VictorChafu/HornSystem_PCB/CommunicationBoard/CommBoard/CommBoard.pdf

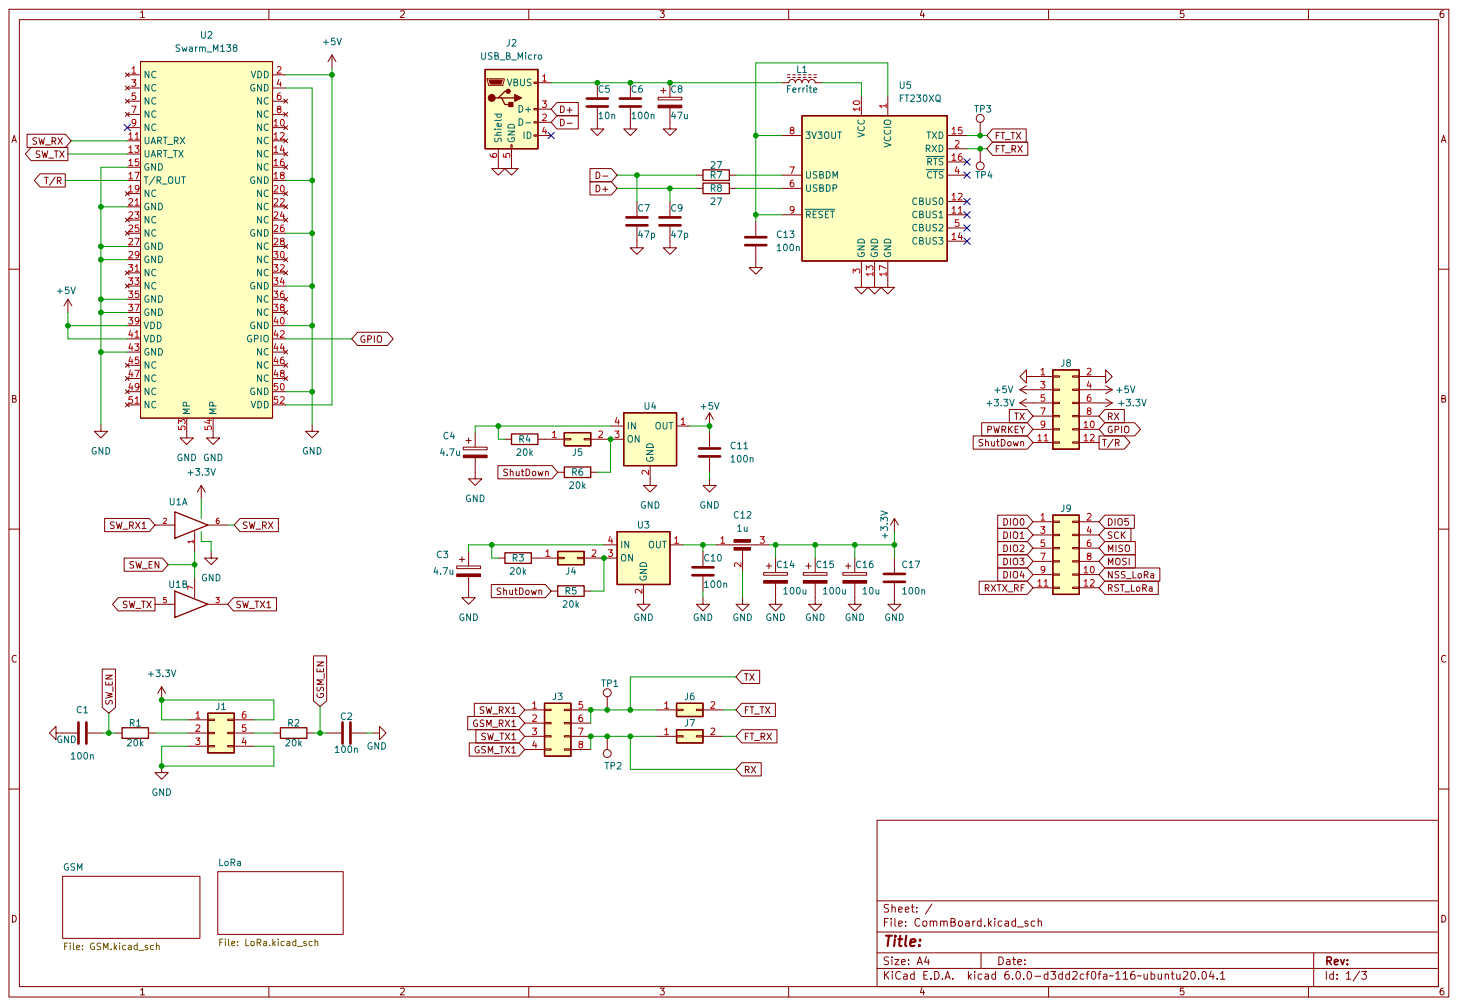
[picture p1: page 1]

1 VCC 10 CBUS1 11 CBUS0 12 GND 13 CBUS3 14 TXD 15 ~{RTS} 16 GND 17 RXD 2 GND

File: CommBoard.kicad_sch Sheet: / GSM

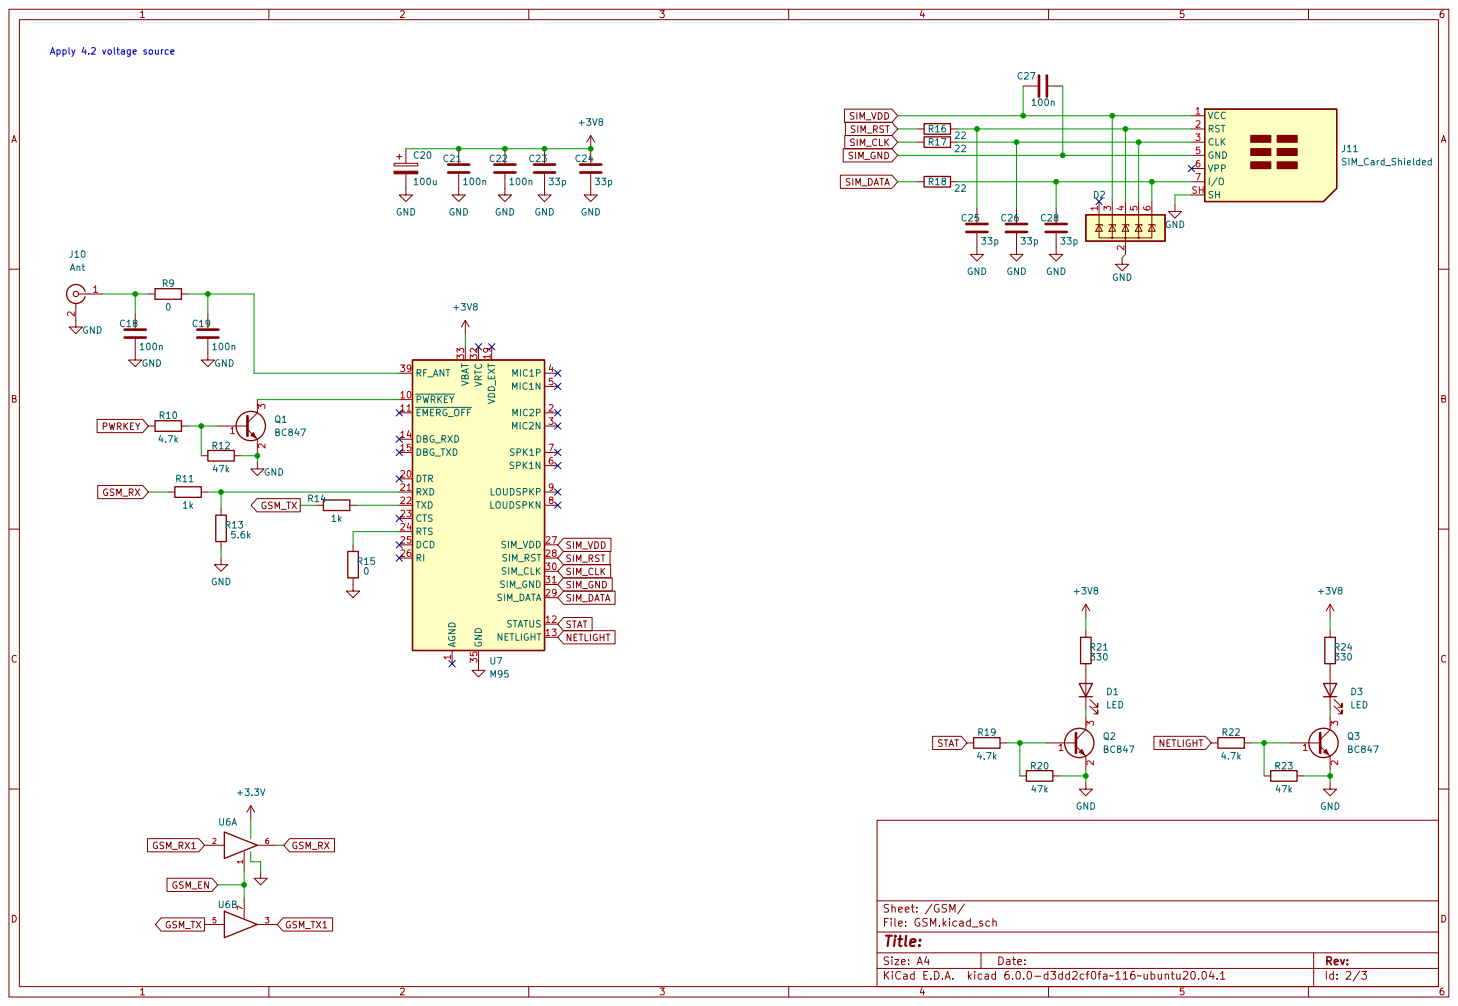
[picture p2: page 2]

VCC 1 RST 2 CLK 3 GND 5 VPP 6

1 ~{PWRKEY} 10 ~{EMERG_OFF} 11 STATUS 12 NETLIGHT 13 DBG_RXD 14 DBG_TXD 15 VDD_EXT 19 MIC2P 2 DTR 20 RXD 21 TXD 22 CTS 23 RTS 24 DCD 25 RI 26 SIM_VDD 27 SIM_RST 28 SIM_DATA 29 MIC2N 3 SIM_CLK 30 SIM_GND 31 VRTC 32 VBAT 33 GND 35 RF_ANT 39 MIC1P 4 MIC1N 5 SPK1N 6 SPK1P 7

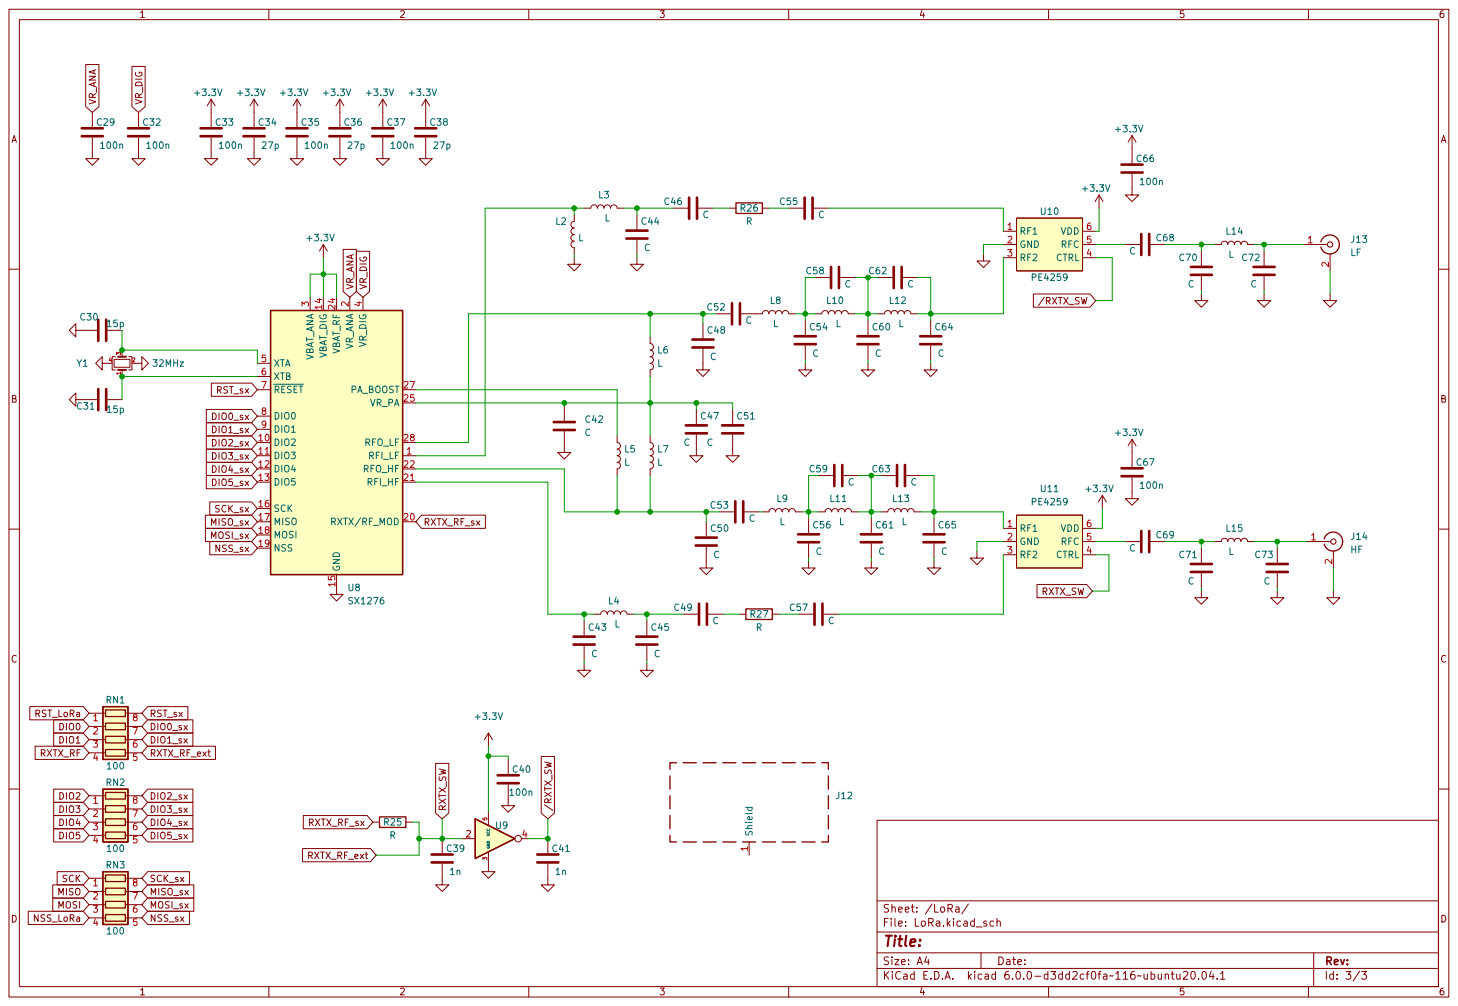
[picture p3: page 3]

File: LoRa.kicad_sch Sheet: /LoRa/
Id: 3/3 Title:
