VictorChafu/HornSystem_PCB/CommunicationBoard/CommBoard/CommBoard.kicad_pcb

## KiCad design CommunicationBoard/CommBoard/CommBoard.kicad_pcb (2022-12-02)

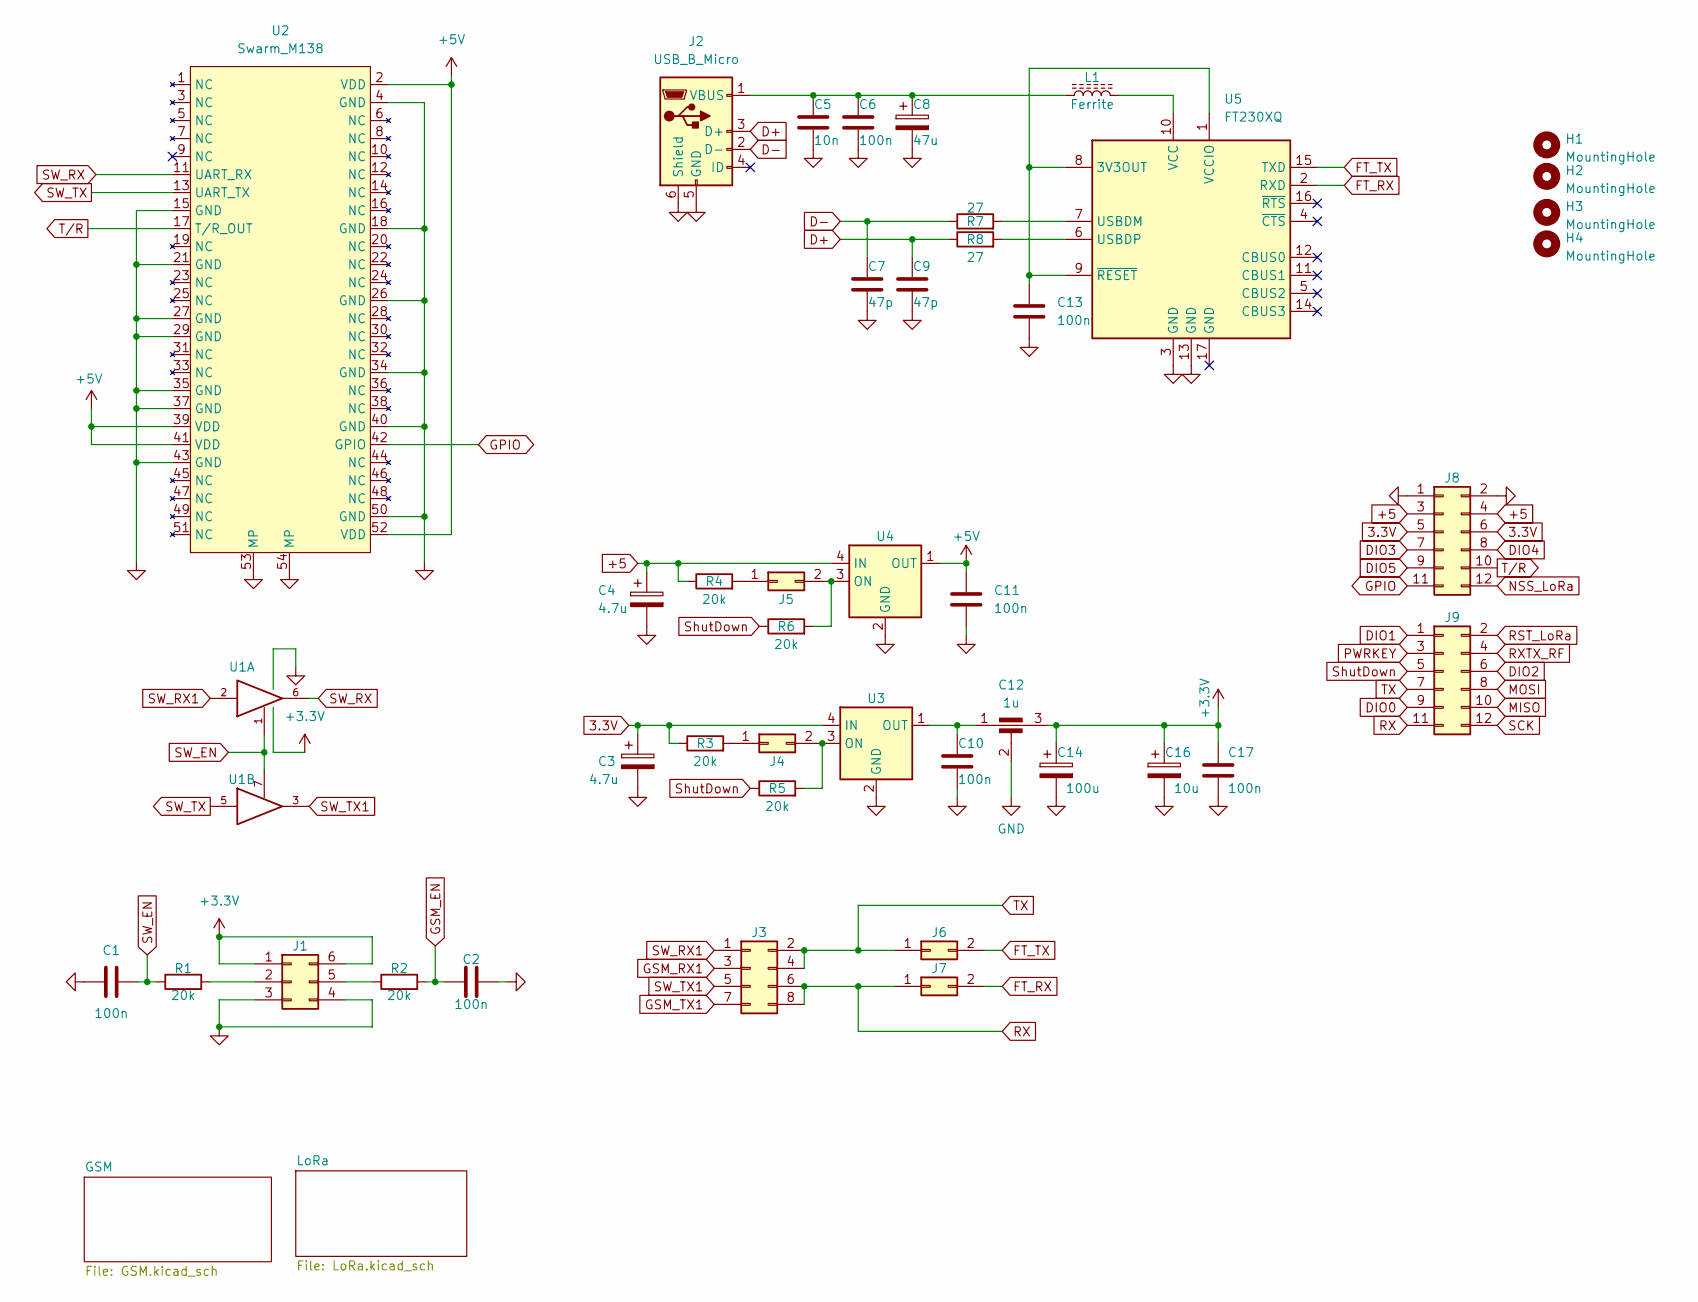
[picture p4: schematic CommBoard.kicad_sch]

Parts:
C1, C2, C6, C10, C11, C13, C17: 100n; C_0402_1005Metric
C3, C4: 4.7u; CP_Elec_6.3x5.2
C5: 10n; C_0402_1005Metric
C7, C9: 47p; C_0402_1005Metric
C8: 47u; CP_Elec_6.3x5.2
C12: 1u; YFF31HC
C14: 100u; CP_Elec_6.3x5.2
C16: 10u; CP_Elec_6.3x5.2
H1, H2, H3, H4: MountingHole; MountingHole_2.5mm
J1: Conn_02x03_Counter_Clockwise; PinHeader_2x03_P2.54mm_Vertical
J2: USB_B_Micro; USB_Micro-B_Molex_47346-0001
J3: Conn_02x04_Top_Bottom; PinHeader_2x04_P2.54mm_Vertical
J4, J5, J6, J7: Conn_02x01; PinHeader_2x01_P2.54mm_Vertical
J8, J9: Conn_02x06_Odd_Even; PinHeader_2x06_P2.54mm_Vertical
L1: Ferrite; L_0402_1005Metric
R1, R2, R3, R4, R5, R6: 20k; R_0402_1005Metric
R7, R8: 27; R_0402_1005Metric
U1: 74LVC2G126; VSSOP-8_2.4x2.1mm_P0.5mm
U2: Swarm_M138; BUS_PCI_Express_Mini_Dual
U3, U4: SiP35508; SOT-23-6
U5: FT230XQ; SSOP-16_3.9x4.9mm_P0.635mm

Connections:
3.3V: C3.1, J8.5, J8.6, R3.1, U3.4 (IN)
+3V3: C12.3, C14.1, C16.1, C17.1, J1.1, J1.6, U1.8 (VCC); also elsewhere on the board
+5: C4.1, J8.3, J8.4, R4.1, U4.4 (IN)
+5V: C11.1, U2.2 (VDD), U2.39 (VDD), U2.41 (VDD), U2.52 (VDD), U4.1 (OUT); also elsewhere on the board
D+: C9.1, J2.3 (D+), R8.1
D-: C7.1, J2.2 (D-), R7.1
DIO0: J9.9; also elsewhere on the board
DIO1: J9.1; also elsewhere on the board
DIO2: J9.6; also elsewhere on the board
DIO3: J8.7; also elsewhere on the board
DIO4: J8.8; also elsewhere on the board
DIO5: J8.9; also elsewhere on the board
FT_RX: J7.2, U5.2 (RXD)
FT_TX: J6.2, U5.15 (TXD)
GND: C1.1, C2.2, C3.2, C4.2, C5.2, C6.2, C7.2, C8.2, C9.2, C10.2, C11.2, C12.2, C13.2, C14.2, C16.2, C17.2, J1.3, J1.4, J2.5 (GND), J2.6 (Shield), J8.1, J8.2, U1.4 (GND), U2.4 (GND), U2.15 (GND), U2.18 (GND), U2.21 (GND), U2.26 (GND), U2.27 (GND), U2.29 (GND), U2.34 (GND), U2.35 (GND), U2.37 (GND), U2.40 (GND), U2.43 (GND), U2.50 (GND), U2.53 (MP), U2.54 (MP), U3.2 (GND), U3.5 (GND), U4.2 (GND), U4.5 (GND), U5.3 (GND), U5.13 (GND); also elsewhere on the board
GPIO: J8.11, U2.42 (GPIO)
GSM_EN: C2.1, R2.2; also elsewhere on the board
GSM_RX1: J3.3; also elsewhere on the board
GSM_TX1: J3.7; also elsewhere on the board
MISO: J9.10; also elsewhere on the board
MOSI: J9.8; also elsewhere on the board
NSS_LoRa: J8.12; also elsewhere on the board
unnamed: C5.1, C6.1, C8.1, J2.1 (VBUS), L1.1
unnamed: C10.1, C12.1, U3.1 (OUT)
unnamed: C13.1, U5.1 (VCCIO), U5.8 (3V3OUT), U5.9 (~RESET)
unnamed: J1.2, R1.2
unnamed: J1.5, R2.1
unnamed: J4.1, R3.2
unnamed: J4.2, R5.2, U3.3 (ON)
unnamed: J5.1, R4.2
unnamed: J5.2, R6.2, U4.3 (ON)
unnamed: L1.2, U5.10 (VCC)
unnamed: R7.2, U5.7 (USBDM)
unnamed: R8.2, U5.6 (USBDP)
PWRKEY: J9.3; also elsewhere on the board
RST_LoRa: J9.2; also elsewhere on the board
RX: J3.6, J3.8, J7.1, J9.11
RXTX_RF: J9.4; also elsewhere on the board
SCK: J9.12; also elsewhere on the board
SW_EN: C1.2, R1.1, U1.1, U1.7
SW_RX: U1.6, U2.11 (UART_RX)
SW_RX1: J3.1, U1.2
SW_TX: U1.5, U2.13 (UART_TX)
SW_TX1: J3.5, U1.3
ShutDown: J9.5, R5.1, R6.1
TX: J3.2, J3.4, J6.1, J9.7
T/R: J8.10, U2.17 (T/R_OUT)

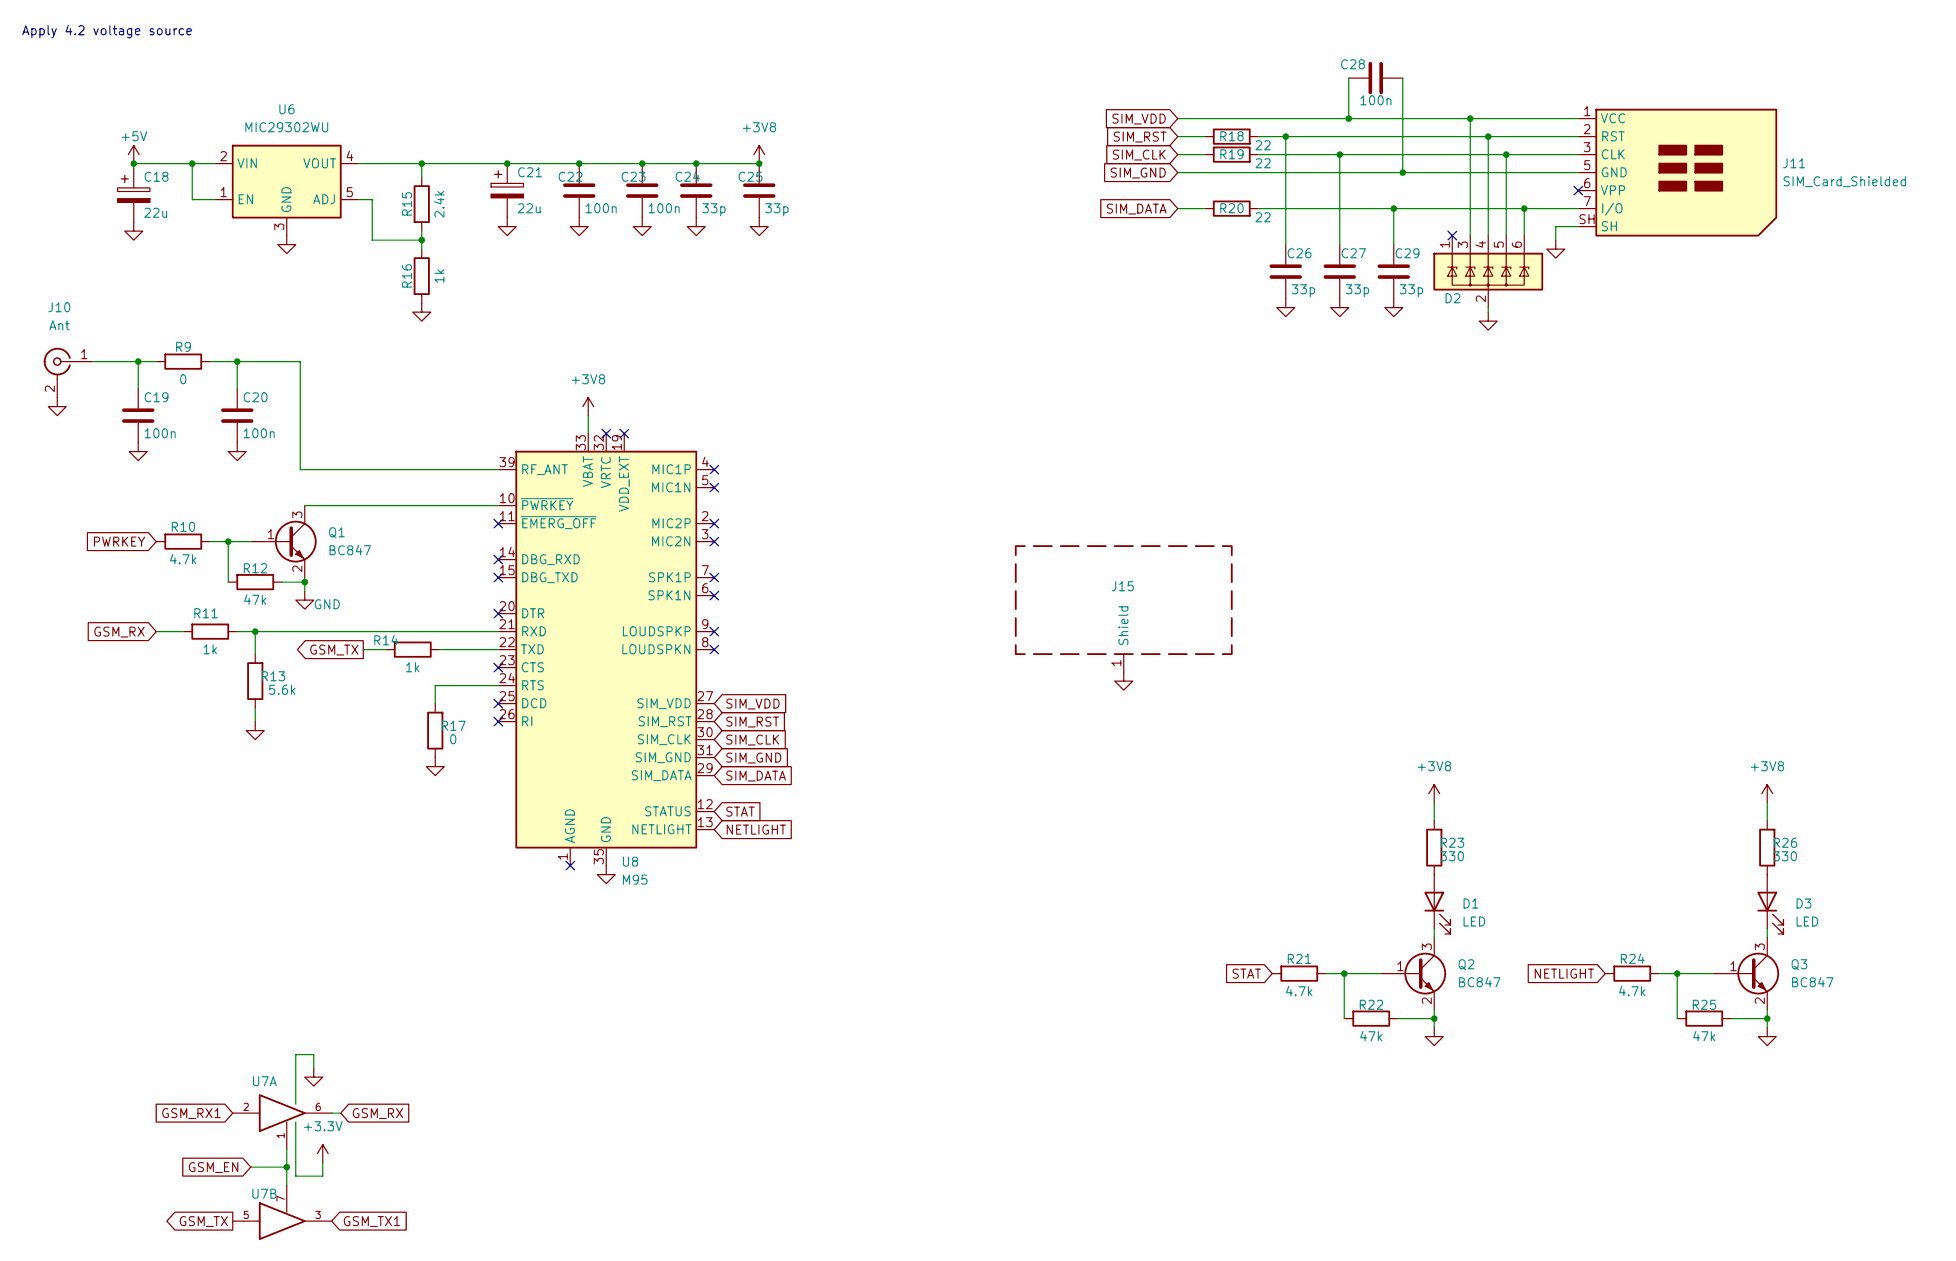
[picture p5: schematic GSM.kicad_sch]

Parts:
C18, C21: 22u; CP_Elec_6.3x5.2
C19, C20, C22, C23, C28: 100n; C_0402_1005Metric
C24, C25, C26, C27, C29: 33p; C_0402_1005Metric
D1, D3: LED; LED_0805_2012Metric
D2: ESDA6V1-5SC6; SOT-23-6
J10: Ant; U.FL_Hirose_U.FL-R-SMT-1_Vertical
J11: SIM_Card_Shielded; microSIM_JAE_SF53S006VCBR2000
J15: RFShield_OnePiece; Laird_Technologies_BMI-S-205-F_38.10x25.40mm
Q1, Q2, Q3: BC847; SOT-23
R9: 0; R_0402_1005Metric
R10, R21, R24: 4.7k; R_0402_1005Metric
R11, R14: 1k; R_0402_1005Metric
R12, R22, R25: 47k; R_0402_1005Metric
R13: 5.6k; R_0402_1005Metric
R15: 2.4k; R_0805_2012Metric
R16: 1k; R_0805_2012Metric
R17: 0; R_0805_2012Metric
R18, R19, R20: 22; R_0402_1005Metric
R23, R26: 330; R_0402_1005Metric
U6: MIC29302WU; TO-263-5_TabPin3
U7: 74LVC2G126; VSSOP-8_2.4x2.1mm_P0.5mm
U8: M95; Quectel_M95

Connections:
+3V3: U7.8 (VCC); also elsewhere on the board
+3V8: C21.1, C22.1, C23.1, C24.1, C25.1, R15.1, R23.2, R26.2, U6.4 (VOUT), U8.33 (VBAT), U8.34 (VBAT)
+5V: C18.1, U6.1 (EN), U6.2 (VIN); also elsewhere on the board
GND: C18.2, C19.2, C20.2, C21.2, C22.2, C23.2, C24.2, C25.2, C26.2, C27.2, C29.2, D2.2 (GND), J10.2 (Ext), J11.SH, J15.1 (Shield), Q1.2 (E), Q2.2 (E), Q3.2 (E), R12.1, R13.1, R16.2, R17.1, R22.1, R25.1, U6.3 (GND), U7.4 (GND), U8.35 (GND), U8.36 (GND), U8.37 (GND), U8.38 (GND), U8.40 (GND); also elsewhere on the board
GSM_EN: U7.1, U7.7; also elsewhere on the board
GSM_RX: R11.2, U7.6
GSM_RX1: U7.2; also elsewhere on the board
GSM_TX: R14.2, U7.5
GSM_TX1: U7.3; also elsewhere on the board
NETLIGHT: R24.2, U8.13 (NETLIGHT)
unnamed: C19.1, J10.1 (In), R9.2
unnamed: C20.1, R9.1, U8.39 (RF_ANT)
unnamed: C26.1, D2.4 (IO3), J11.2 (RST), R18.2
unnamed: C27.1, D2.5 (IO4), J11.3 (CLK), R19.2
unnamed: C29.1, D2.6 (IO5), J11.7 (I/O), R20.2
unnamed: D1.1 (K), Q2.3 (C)
unnamed: D1.2 (A), R23.1
unnamed: D3.1 (K), Q3.3 (C)
unnamed: D3.2 (A), R26.1
unnamed: Q1.1 (B), R10.1, R12.2
unnamed: Q1.3 (C), U8.10 (~PWRKEY)
unnamed: Q2.1 (B), R21.1, R22.2
unnamed: Q3.1 (B), R24.1, R25.2
unnamed: R11.1, R13.2, U8.21 (RXD)
unnamed: R14.1, U8.22 (TXD)
unnamed: R15.2, R16.1, U6.5 (ADJ)
unnamed: R17.2, U8.24 (RTS)
PWRKEY: R10.2; also elsewhere on the board
SIM_CLK: R19.1, U8.30 (SIM_CLK)
SIM_DATA: R20.1, U8.29 (SIM_DATA)
SIM_GND: C28.2, J11.5 (GND), U8.31 (SIM_GND)
SIM_RST: R18.1, U8.28 (SIM_RST)
SIM_VDD: C28.1, D2.3 (IO2), J11.1 (VCC), U8.27 (SIM_VDD)
STAT: R21.2, U8.12 (STATUS)

Notes on the sheet:
Apply 4.2 voltage source

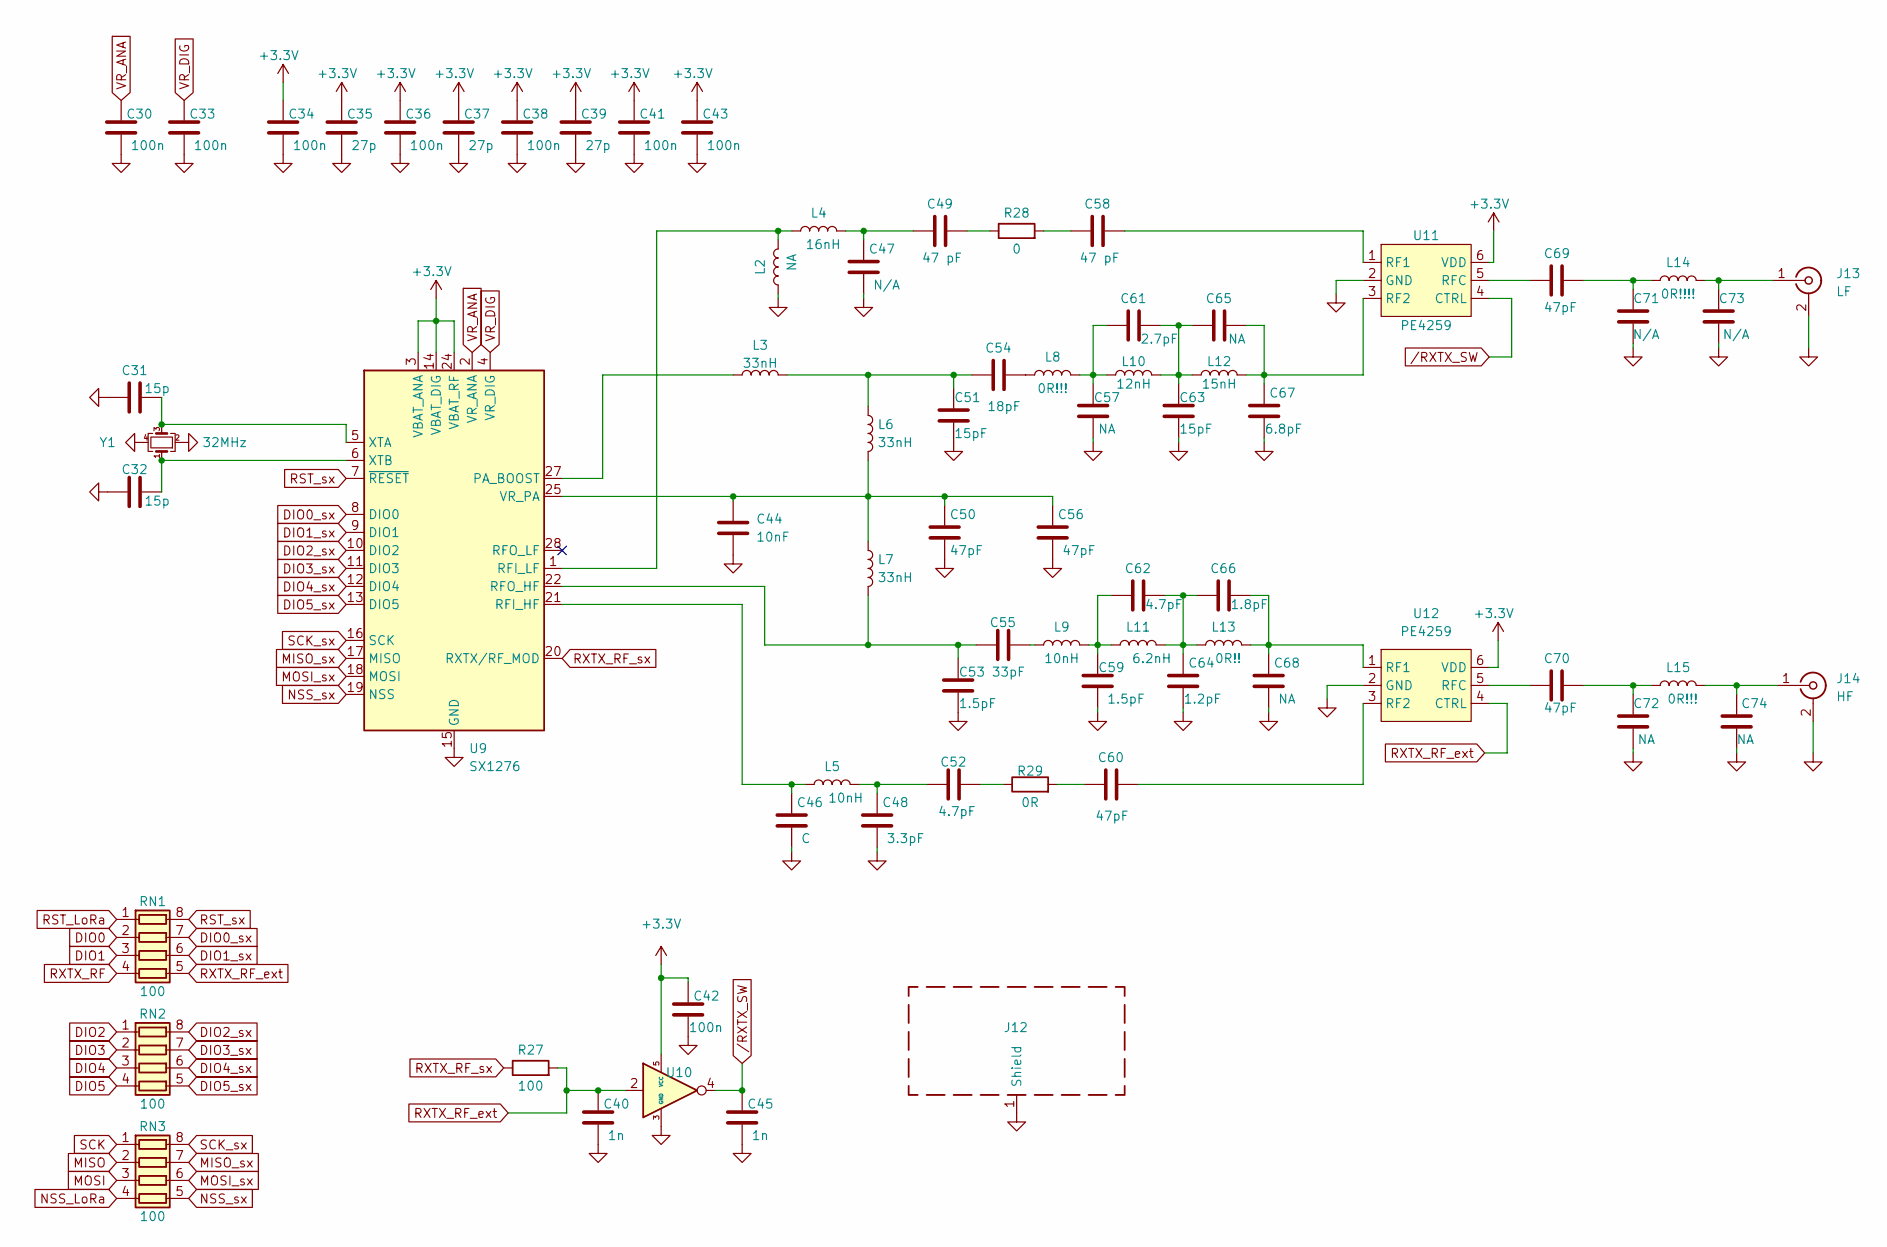
[picture p6: schematic LoRa.kicad_sch]

Parts:
C30, C33, C34, C36, C38, C41, C42, C43: 100n; C_0402_1005Metric
C31, C32: 15p; C_0402_1005Metric
C35, C37, C39: 27p; C_0402_1005Metric
C40, C45: 1n; C_0402_1005Metric
C44: 10nF; C_0402_1005Metric
C46: C; C_0402_1005Metric
C47, C71, C73: N/A; C_0402_1005Metric
C48: 3.3pF; C_0402_1005Metric
C49, C58: 47 pF; C_0402_1005Metric
C50, C56, C60, C69, C70: 47pF; C_0402_1005Metric
C51, C63: 15pF; C_0402_1005Metric
C52, C62: 4.7pF; C_0402_1005Metric
C53, C59: 1.5pF; C_0402_1005Metric
C54: 18pF; C_0402_1005Metric
C55: 33pF; C_0402_1005Metric
C57, C65, C68, C72, C74: NA; C_0402_1005Metric
C61: 2.7pF; C_0402_1005Metric
C64: 1.2pF; C_0402_1005Metric
C66: 1.8pF; C_0402_1005Metric
C67: 6.8pF; C_0402_1005Metric
J12: RFShield_OnePiece; Laird_Technologies_BMI-S-205-F_38.10x25.40mm
J13: LF; U.FL_Hirose_U.FL-R-SMT-1_Vertical
J14: HF; U.FL_Hirose_U.FL-R-SMT-1_Vertical
L2: NA; L_0402_1005Metric
L3, L6, L7: 33nH; L_0402_1005Metric
L4: 16nH; L_0402_1005Metric
L5, L9: 10nH; L_0402_1005Metric
L8, L15: 0R!!!; L_0402_1005Metric
L10: 12nH; L_0402_1005Metric
L11: 6.2nH; L_0402_1005Metric
L12: 15nH; L_0402_1005Metric
L13: 0R!!; L_0402_1005Metric
L14: 0R!!!!; L_0402_1005Metric
R27: 100; R_0402_1005Metric
R28: 0; R_0201_0603Metric
R29: 0R; R_0201_0603Metric_Pad0.64x0.40mm_HandSolder
RN1, RN2, RN3: 100; R_Array_Convex_4x1206
U9: SX1276; QFN-28-1EP_6x6mm_P0.65mm_EP4.8x4.8mm
U10: NC7SVU04P5X; SOT-353_SC-70-5
U11, U12: PE4259; SC70-6
Y1: 32MHz; Crystal_SMD_Abracon_ABM8G-4Pin_3.2x2.5mm

Connections:
+3V3: C34.1, C35.1, C36.1, C37.1, C38.1, C39.1, C41.1, C42.1, C43.1, U9.3 (VBAT_ANA), U9.14 (VBAT_DIG), U9.24 (VBAT_RF), U10.5 (VCC), U11.6 (VDD), U12.6 (VDD); also elsewhere on the board
DIO0: RN1.2 (R2.1); also elsewhere on the board
DIO0_sx: RN1.7 (R2.2), U9.8 (DIO0)
DIO1: RN1.3 (R3.1); also elsewhere on the board
DIO1_sx: RN1.6 (R3.2), U9.9 (DIO1)
DIO2: RN2.1 (R1.1); also elsewhere on the board
DIO2_sx: RN2.8 (R1.2), U9.10 (DIO2)
DIO3: RN2.2 (R2.1); also elsewhere on the board
DIO3_sx: RN2.7 (R2.2), U9.11 (DIO3)
DIO4: RN2.3 (R3.1); also elsewhere on the board
DIO4_sx: RN2.6 (R3.2), U9.12 (DIO4)
DIO5: RN2.4 (R4.1); also elsewhere on the board
DIO5_sx: RN2.5 (R4.2), U9.13 (DIO5)
GND: C30.2, C31.1, C32.1, C33.2, C34.2, C35.2, C36.2, C37.2, C38.2, C39.2, C40.2, C41.2, C42.2, C43.2, C44.2, C45.2, C46.2, C47.2, C48.2, C50.2, C51.2, C53.2, C56.2, C57.2, C59.2, C63.2, C64.2, C67.2, C68.2, C71.2, C72.2, C73.2, C74.2, J12.1, J13.2 (Ext), J14.2 (Ext), L2.1, U9.15 (GND), U9.23 (GND), U9.26 (GND), U9.29 (GND), U10.3 (GND), U11.2 (GND), U12.2 (GND), Y1.2, Y1.4; also elsewhere on the board
MISO: RN3.2 (R2.1); also elsewhere on the board
MISO_sx: RN3.7 (R2.2), U9.17 (MISO)
MOSI: RN3.3 (R3.1); also elsewhere on the board
MOSI_sx: RN3.6 (R3.2), U9.18 (MOSI)
NSS_LoRa: RN3.4 (R4.1); also elsewhere on the board
NSS_sx: RN3.5 (R4.2), U9.19 (NSS)
unnamed: C31.2, U9.5 (XTA), Y1.3
unnamed: C32.2, U9.6 (XTB), Y1.1
unnamed: C44.1, C50.1, C56.1, L6.2, L7.1, U9.25 (VR_PA)
unnamed: C46.1, L5.1, U9.21 (RFI_HF)
unnamed: C47.1, C49.1, L4.2
unnamed: C48.1, C52.1, L5.2
unnamed: C49.2, R28.1
unnamed: C51.1, C54.1, L3.2, L6.1
unnamed: C52.2, R29.1
unnamed: C53.1, C55.1, L7.2, U9.22 (RFO_HF)
unnamed: C54.2, L8.1
unnamed: C55.2, L9.1
unnamed: C57.1, C61.1, L8.2, L10.1
unnamed: C58.1, R28.2
unnamed: C58.2, U11.1 (RF1)
unnamed: C59.1, C62.1, L9.2, L11.1
unnamed: C60.1, R29.2
unnamed: C60.2, U12.3 (RF2)
unnamed: C61.2, C63.1, C65.1, L10.2, L12.1
unnamed: C62.2, C64.1, C66.1, L11.2, L13.1
unnamed: C65.2, C67.1, L12.2, U11.3 (RF2)
unnamed: C66.2, C68.1, L13.2, U12.1 (RF1)
unnamed: C69.1, C71.1, L14.2
unnamed: C69.2, U11.5 (RFC)
unnamed: C70.1, C72.1, L15.2
unnamed: C70.2, U12.5 (RFC)
unnamed: C73.1, J13.1 (In), L14.1
unnamed: C74.1, J14.1 (In), L15.1
unnamed: L2.2, L4.1, U9.1 (RFI_LF)
unnamed: L3.1, U9.27 (PA_BOOST)
RST_LoRa: RN1.1 (R1.1); also elsewhere on the board
RST_sx: RN1.8 (R1.2), U9.7 (~RESET)
RXTX_RF: RN1.4 (R4.1); also elsewhere on the board
RXTX_RF_ext: C40.1, R27.2, RN1.5 (R4.2), U10.2, U12.4 (CTRL)
RXTX_RF_sx: R27.1, U9.20 (RXTX/RF_MOD)
SCK: RN3.1 (R1.1); also elsewhere on the board
SCK_sx: RN3.8 (R1.2), U9.16 (SCK)
VR_ANA: C30.1, U9.2 (VR_ANA)
VR_DIG: C33.1, U9.4 (VR_DIG)
/RXTX_SW: C45.1, U10.4, U11.4 (CTRL)

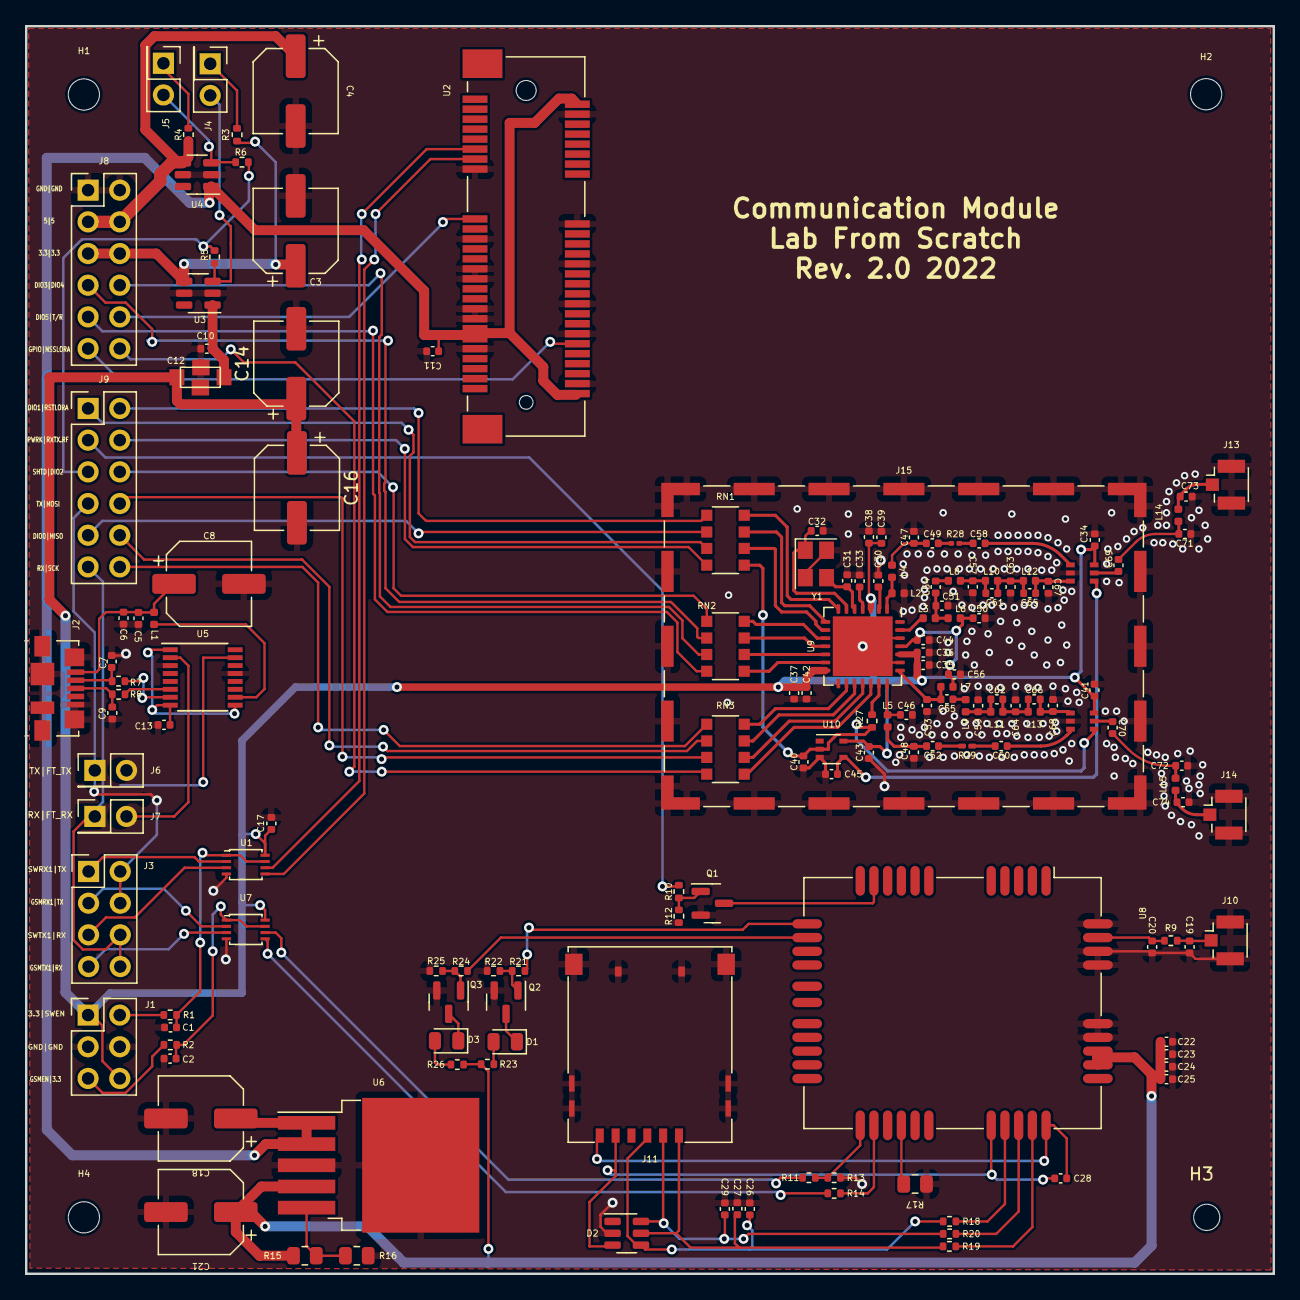
[picture p7: board CommBoard.kicad_pcb from above]

Board: 2 copper layers, 100.0 x 100.0 mm, 157 parts (0 on the bottom side), 120 nets.
