VictorChafu/HornSystem_PCB/power_board/PCB-DESIGN/power_board.kicad_pcb

## KiCad design power_board/PCB-DESIGN/power_board.kicad_pcb (2022-12-02)

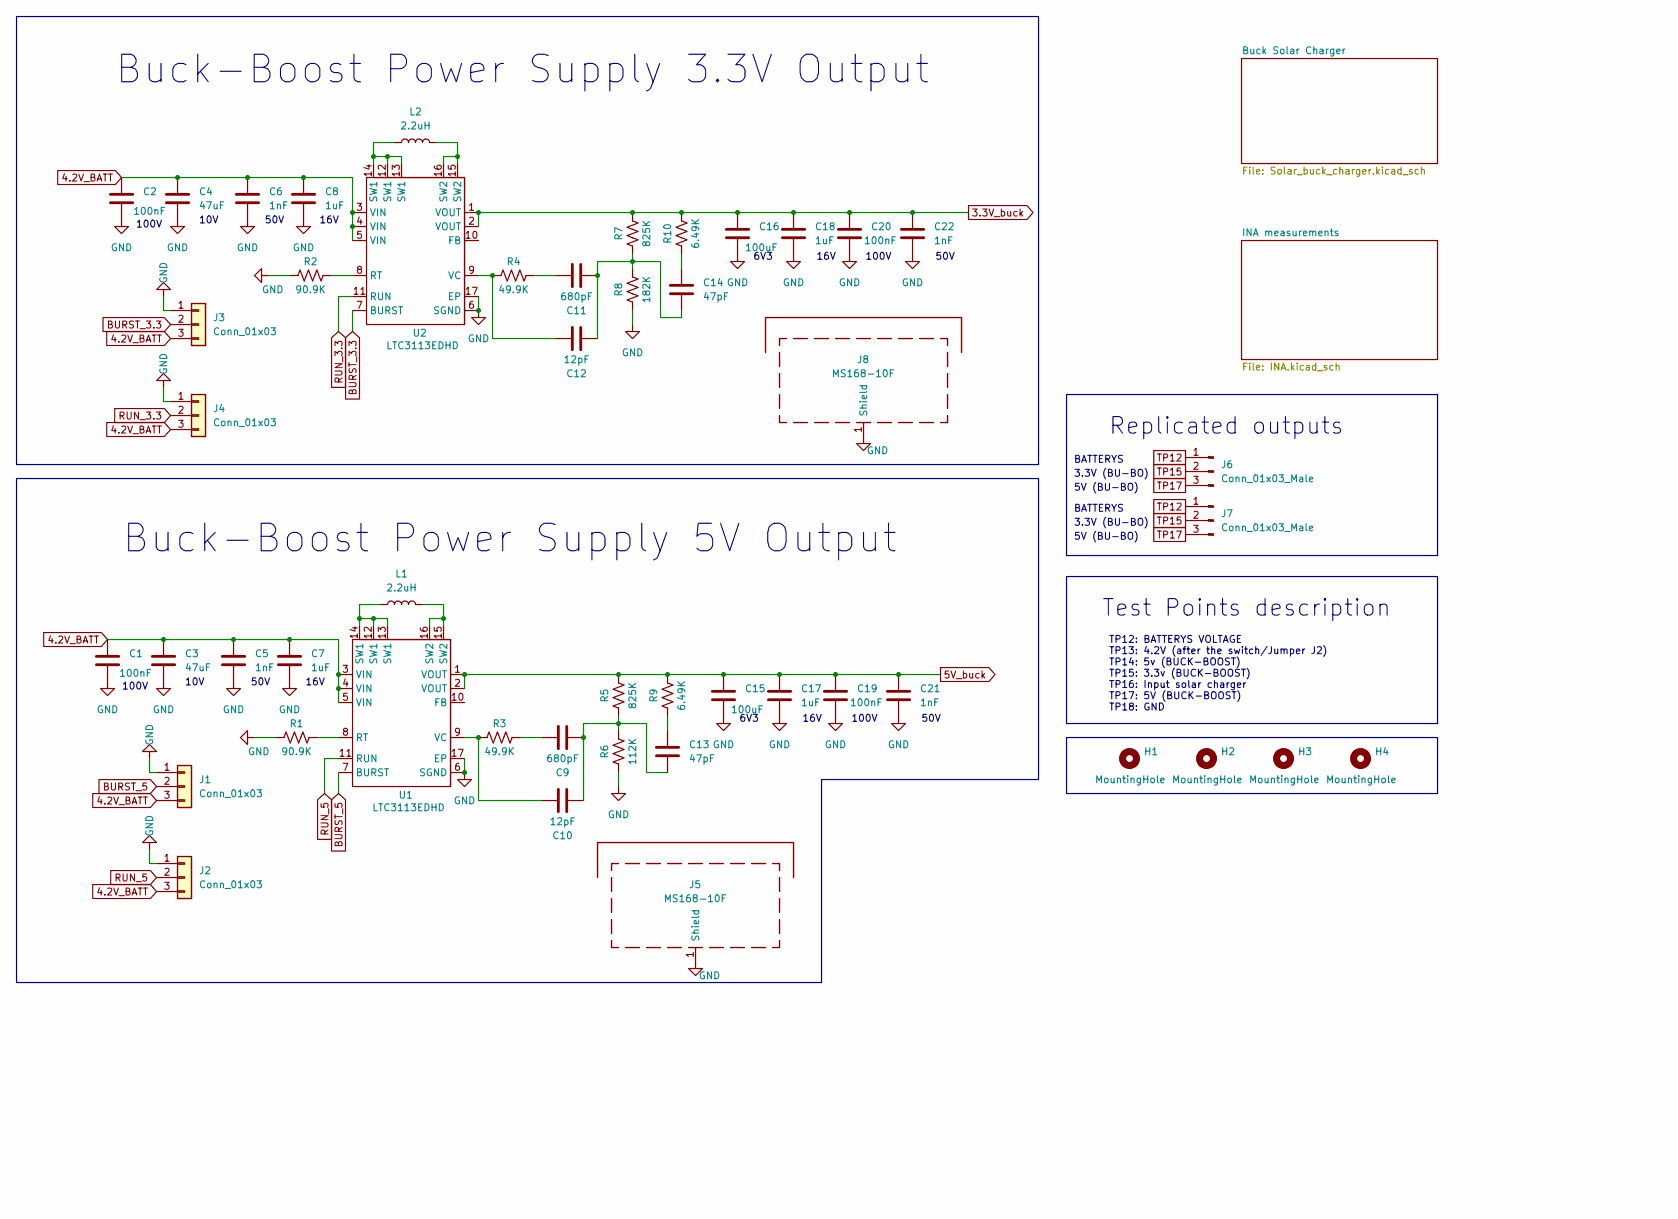
[picture p8: schematic power_board.kicad_sch, Navy System. Power Board, part in row 1, column 1]

Parts:
C1, C2, C19, C20: 100nF; C_0805_2012Metric
C3, C4: 47uF; C_0805_2012Metric
C5, C6, C21, C22: 1nF; C_0805_2012Metric
C7, C8, C17, C18: 1uF; C_0805_2012Metric
C9, C11: 680pF; C_0805_2012Metric
C10, C12: 12pF; C_0805_2012Metric
C13, C14: 47pF; C_0805_2012Metric
C15, C16: 100uF; C_0805_2012Metric
H1, H2, H3, H4: MountingHole; MountingHole_2.5mm
J1, J2, J3, J4: Conn_01x03; PinHeader_1x03_P2.54mm_Vertical
J5, J8: MS168-10F; Wuerth_36103205_20x20mm
J6, J7: Conn_01x03_Male; PinHeader_1x03_P2.54mm_Vertical
L1, L2: 2.2uH; L_Vishay_IHLP-2525
R1, R2: 90.9K; R_0805_2012Metric
R3, R4: 49.9K; R_0805_2012Metric
R5, R7: 825K; R_0805_2012Metric
R6: 112K; R_0805_2012Metric
R8: 182K; R_0805_2012Metric
R9, R10: 6.49K; R_0805_2012Metric
U1, U2: LTC3113EDHD; SSOP-20_4.4x6.5mm_P0.65mm

Connections:
3.3V_buck: C16.1, C18.1, C20.1, C22.1, R7.1, R10.1, U2.1 (VOUT), U2.2 (VOUT); also elsewhere on the board
4.2V_BATT: C1.1, C2.1, C3.1, C4.1, C5.1, C6.1, C7.1, C8.1, J1.3, J2.3, J3.3, J4.3, J6.1, J7.1, U1.3 (VIN), U1.4 (VIN), U1.5 (VIN), U2.3 (VIN), U2.4 (VIN), U2.5 (VIN); also elsewhere on the board
5V_buck: C15.1, C17.1, C19.1, C21.1, R5.1, R9.1, U1.1 (VOUT), U1.2 (VOUT); also elsewhere on the board
BURST_3.3: J3.2, U2.7 (BURST)
BURST_5: J1.2, U1.7 (BURST)
GND: C1.2, C2.2, C3.2, C4.2, C5.2, C6.2, C7.2, C8.2, C15.2, C16.2, C17.2, C18.2, C19.2, C20.2, C21.2, C22.2, J1.1, J2.1, J3.1, J4.1, J5.1 (Shield), J8.1 (Shield), R1.2, R2.2, R6.2, R8.2, U1.6 (SGND), U1.17 (EP), U2.6 (SGND), U2.17 (EP); also elsewhere on the board
unnamed: C9.2, R3.1
unnamed: C9.1, C10.1, C13.2, R5.2, R6.1
unnamed: C10.2, R3.2, U1.9 (VC)
unnamed: C11.1, C12.1, C14.2, R7.2, R8.1
unnamed: C11.2, R4.1
unnamed: C12.2, R4.2, U2.9 (VC)
unnamed: C13.1, R9.2
unnamed: C14.1, R10.2
unnamed: L1.1, U1.12 (SW1), U1.13 (SW1), U1.14 (SW1)
unnamed: L1.2, U1.15 (SW2), U1.16 (SW2)
unnamed: L2.1, U2.12 (SW1), U2.13 (SW1), U2.14 (SW1)
unnamed: L2.2, U2.15 (SW2), U2.16 (SW2)
unnamed: R1.1, U1.8 (RT)
unnamed: R2.1, U2.8 (RT)
RUN_3.3: J4.2, U2.11 (RUN)
RUN_5: J2.2, U1.11 (RUN)
TP15: J6.2, J7.2
TP17: J6.3, J7.3

Notes on the sheet:
16V
100V
TP12: BATTERYS VOLTAGE TP13: 4.2V (after the switch/Jumper J2) TP14: 5v (BUCK-BOOST) TP15: 3.3v (BUCK-BOOST) TP16: Input solar charger TP17: 5V (BUCK-BOOST) TP18: GND
3.3V (BU-BO)
50V
Buck-Boost Power Supply 3.3V Output
5V (BU-BO)
6V3
Buck-Boost Power Supply 5V Output
BATTERYS
10V
Replicated outputs
Test Points description

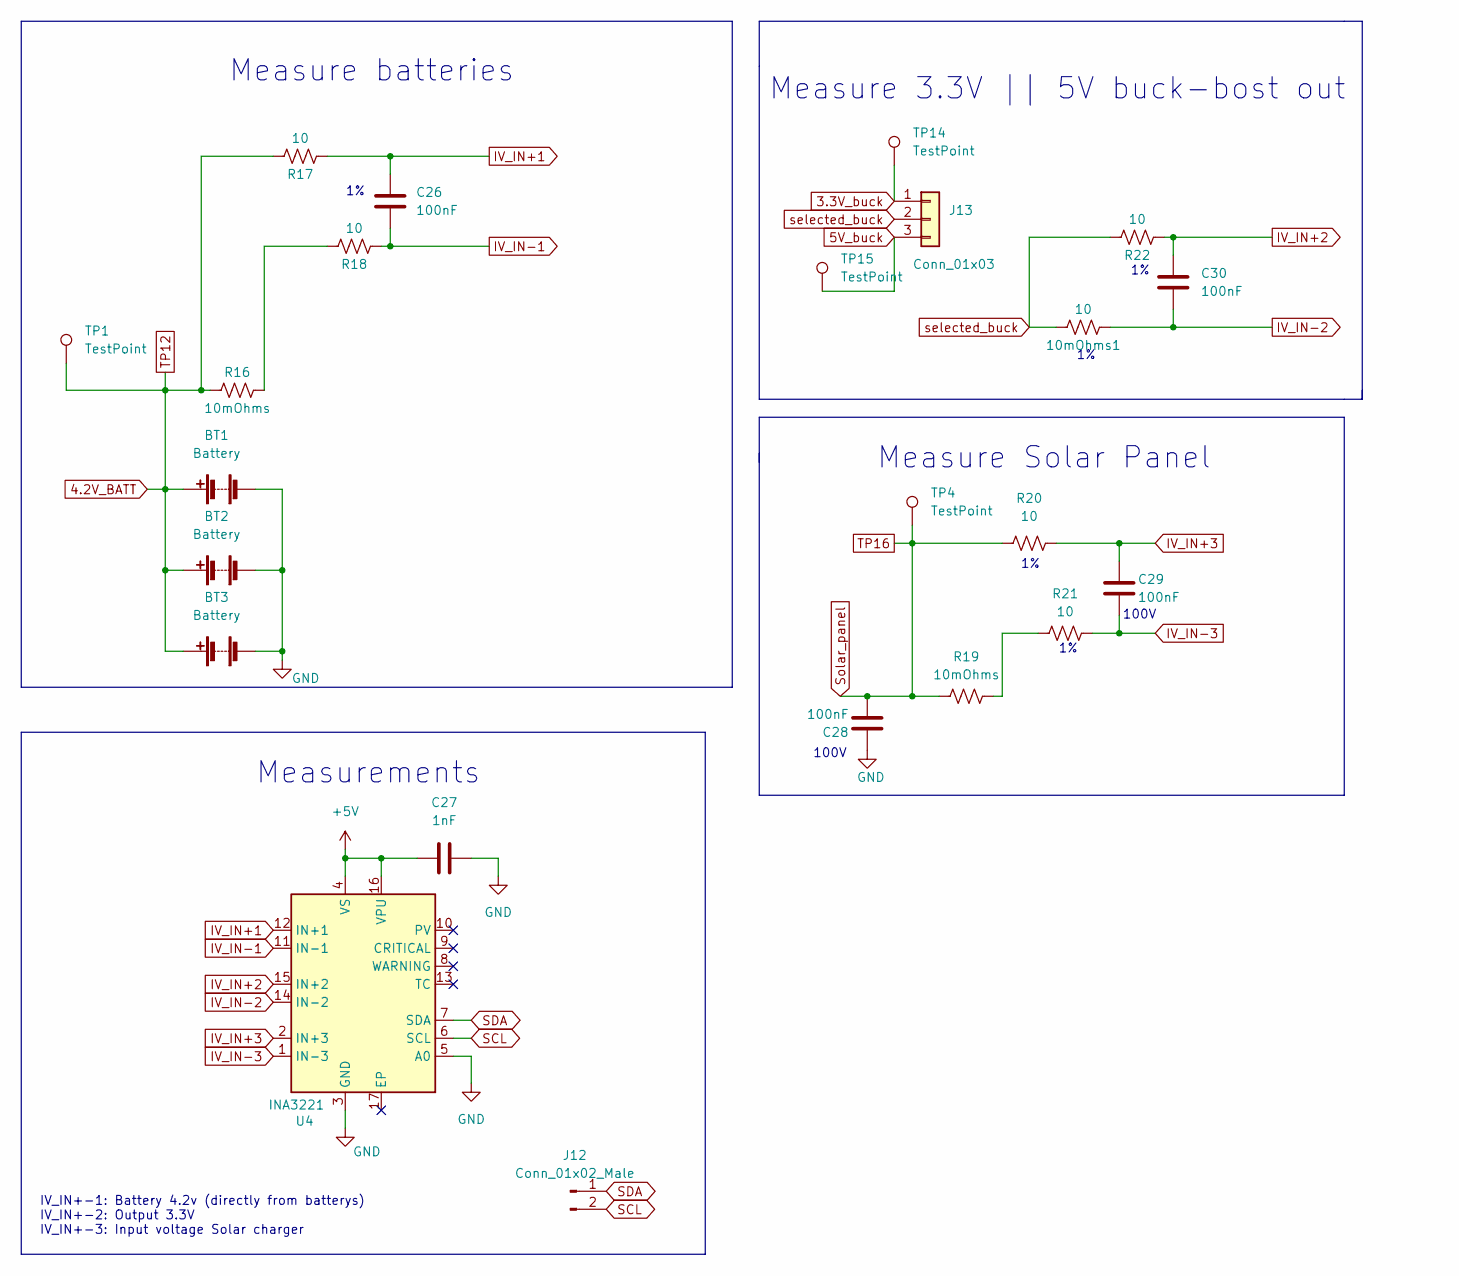
[picture p9: schematic INA.kicad_sch]

Parts:
10mOhms1: 10; R_0805_2012Metric
BT1, BT2, BT3: Battery; BatteryHolder_MPD_BH-18650-PC2
C26, C28, C29, C30: 100nF; C_0805_2012Metric
C27: 1nF; C_0805_2012Metric
J12: Conn_01x02_Male; PinHeader_1x02_P2.54mm_Vertical
J13: Conn_01x03; PinHeader_1x03_P2.54mm_Vertical
R16, R19: 10mOhms; R_0805_2012Metric
R17, R18, R20, R21, R22: 10; R_0805_2012Metric
TP1, TP4, TP14, TP15: TestPoint; TestPoint_Loop_D2.54mm_Drill1.5mm_Beaded
U4: INA3221; Texas_RGV_S-PVQFN-N16_EP2.1x2.1mm

Connections:
3.3V_buck: J13.1, TP14.1; also elsewhere on the board
4.2V_BATT: BT1.1 (+), BT2.1 (+), BT3.1 (+), R16.1, R17.1, TP1.1; also elsewhere on the board
5V_buck: J13.3, TP15.1; also elsewhere on the board
+5V: C27.1, U4.4 (VS), U4.16 (VPU)
GND: BT1.2 (-), BT2.2 (-), BT3.2 (-), C27.2, C28.1, U4.3 (GND), U4.5 (A0); also elsewhere on the board
IV_IN+1: C26.1, R17.2, U4.12 (IN+1)
IV_IN+2: C30.1, R22.2, U4.15 (IN+2)
IV_IN+3: C29.1, R20.1, U4.2 (IN+3)
IV_IN-1: C26.2, R18.2, U4.11 (IN-1)
IV_IN-2: 10mOhms1.2, C30.2, U4.14 (IN-2)
IV_IN-3: C29.2, R21.1, U4.1 (IN-3)
unnamed: R16.2, R18.1
unnamed: R19.1, R21.2
SCL: J12.2, U4.6 (SCL)
SDA: J12.1, U4.7 (SDA)
Solar_panel: C28.2, R19.2, R20.2, TP4.1; also elsewhere on the board
selected_buck: 10mOhms1.1, J13.2, R22.1

Notes on the sheet:
100V
Measure Solar Panel
Measurements
IV_IN+-1: Battery 4.2v (directly from batterys) IV_IN+-2: Output 3.3V IV_IN+-3: Input voltage Solar charger
Measure batteries
Measure 3.3V || 5V buck-bost out

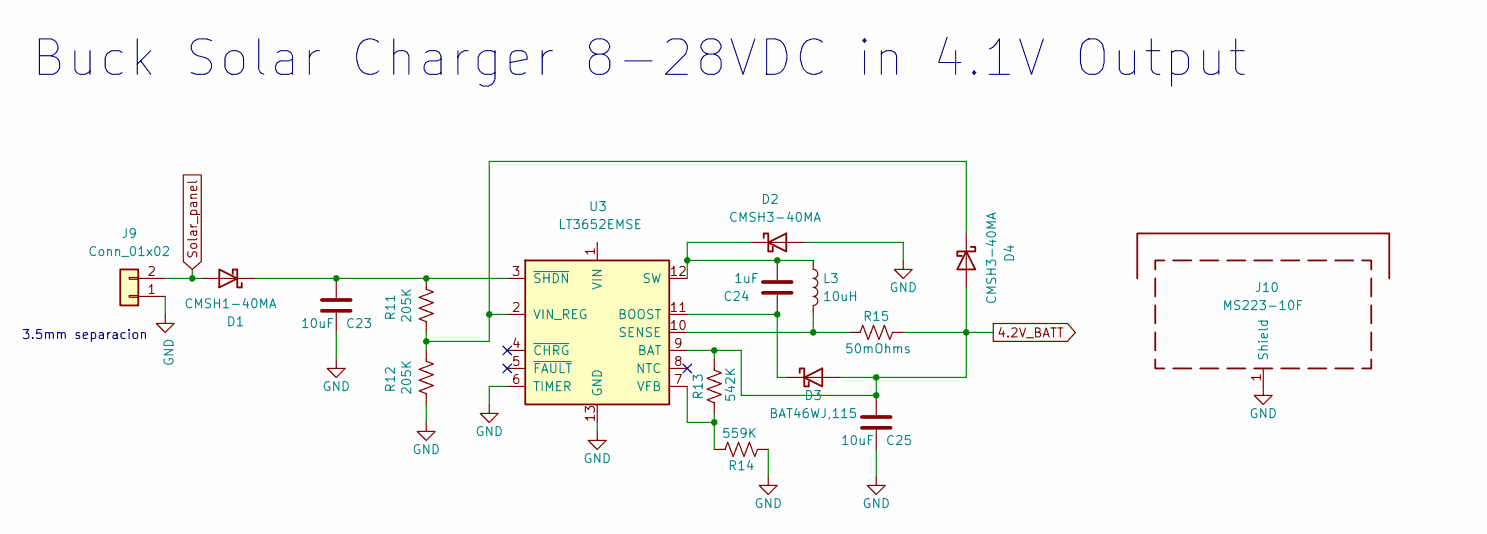
[picture p10: schematic Solar_buck_charger.kicad_sch]

Parts:
C23, C25: 10uF; C_0805_2012Metric
C24: 1uF; C_0805_2012Metric
D1: CMSH1-40MA; D_SOD-128
D2, D4: CMSH3-40MA; D_SOD-128
D3: BAT46WJ,115; D_SOD-323F
J9: Conn_01x02; TerminalBlock_Phoenix_PT-1,5-2-3.5-H_1x02_P3.50mm_Horizontal
J10: MS223-10F; Wuerth_36103255_25x25mm
L3: 10uH; L_Vishay_IHLP-2525
R11, R12: 205K; R_0805_2012Metric
R13: 542K; R_0805_2012Metric
R14: 559K; R_0805_2012Metric
R15: 50mOhms; R_0805_2012Metric
U3: LT3652EMSE; MSOP-12-1EP_3x4mm_P0.65mm_EP1.65x2.85mm

Connections:
4.2V_BATT: C25.1, D3.2 (A), D4.2 (A), R13.1, R15.1, U3.9 (BAT); also elsewhere on the board
GND: C23.2, C25.2, D2.2 (A), J9.1, J10.1 (Shield), R12.1, R14.2, U3.6 (TIMER), U3.13 (GND); also elsewhere on the board
unnamed: C23.1, D1.1 (K), R11.2, U3.3 (~SHDN)
unnamed: C24.1, D3.1 (K), U3.11 (BOOST)
unnamed: C24.2, D2.1 (K), L3.1, U3.12 (SW)
unnamed: D4.1 (K), R11.1, R12.2, U3.2 (VIN_REG)
unnamed: L3.2, R15.2, U3.10 (SENSE)
unnamed: R13.2, R14.1, U3.7 (VFB)
Solar_panel: D1.2 (A), J9.2; also elsewhere on the board

Notes on the sheet:
Buck Solar Charger 8-28VDC in 4.1V Output
3.5mm separacion
