VictorChafu/HornSystem_PCB/power_board/PCB-DESIGN/power_board.kicad_pcb

## KiCad design power_board/PCB-DESIGN/power_board.kicad_pcb (continued)

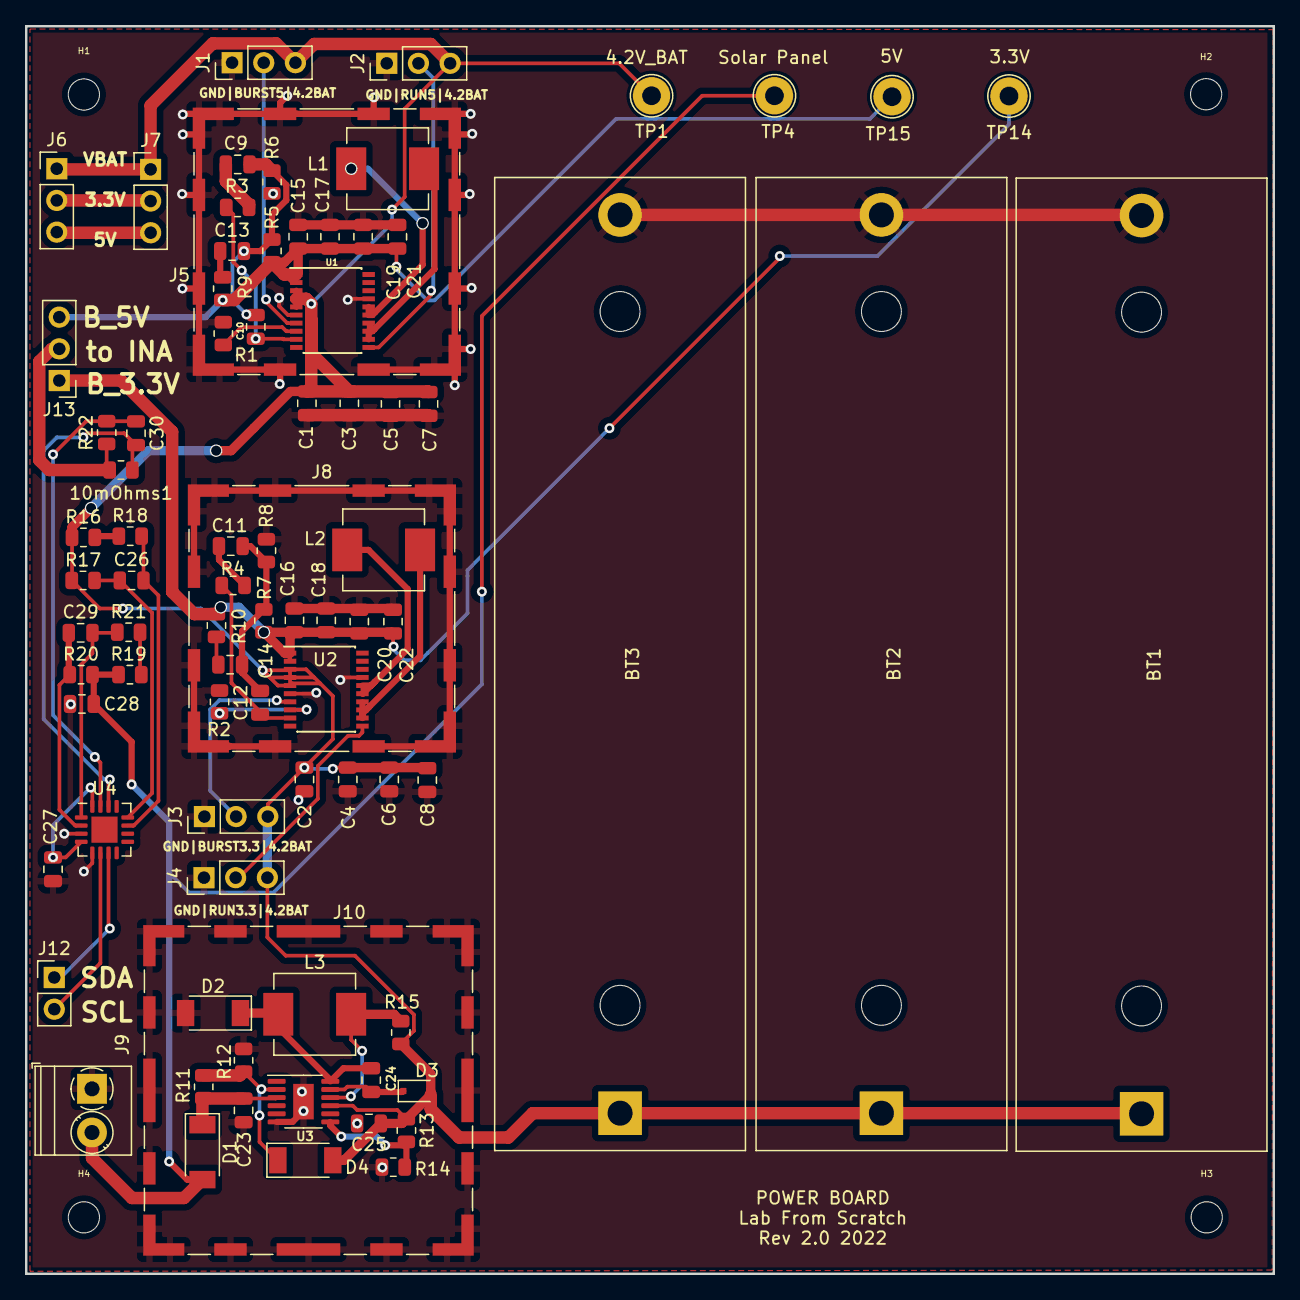
[picture p11: board power_board.kicad_pcb from above]

Board: 4 copper layers, 100.0 x 100.0 mm, 87 parts (0 on the bottom side), 43 nets.
